liveboxandy/ZX-Spectrum-48K-Issue-6A/Issue6A.csv

Reference | Value | Footprint | Qty | Description
C1,C2,C3,C4,C5,C6,C7,C8,C26,C29,C30,C40,C41,C42,C48,C55,C56,C57,C58,C59,C60,C61,C62,C66,C76,C101,C102,C104 | 22nF | Mod:C_Axial_L3.8mm_D2.6mm_P12.70mm_Horizontal | 28 | Capacitor Ceramic MLCC
C25,C28,C34,C50,C65,C80 | 22uF | Mod:CP_Axial_L11.0mm_D6.0mm_P20.00mm_Horizontal,Mod:CP_Axial_L11.0mm_D6.0mm_P20.32mm_Horizontal | 6 | Capacitor Aluminium Electrolytic
C27,C46,C79 | 1uF | Mod:CP_Axial_L11.0mm_D6.0mm_P20.32mm_Horizontal | 3 | Capacitor Aluminium Electrolytic
C31,C32,C43,C68,C69,C70,C71,C75 | 100nF | Mod:C_Axial_L3.8mm_D2.6mm_P12.40mm_Horizontal,Mod:C_Axial_L3.8mm_D2.6mm_P12.70mm_Horizontal | 8 | Capacitor Ceramic MLCC
C33 | 47nF | Mod:C_Axial_L3.8mm_D2.6mm_P12.70mm_Horizontal | 1 | Capacitor Ceramic MLCC
C35,C39,C100 | 10nF | Mod:C_Axial_L3.8mm_D2.6mm_P12.40mm_Horizontal,Mod:C_Axial_L3.8mm_D2.6mm_P12.70mm_Horizontal,Mod:R_Yageo_L3.6mm_D1.6mm_P12.70mm_Horizontal | 3 | Capacitor Ceramic MLCC
C37,C38 | 33pF | Mod:C_Axial_L3.8mm_D2.6mm_P12.70mm_Horizontal | 2 | Capacitor Ceramic MLCC
C44,C45 | 100uF | Mod:CP_Axial_L11.0mm_D6.0mm_P20.32mm_Horizontal | 2 | Capacitor Aluminium Electrolytic
C49 | 560pF | Mod:C_Axial_L3.8mm_D2.6mm_P12.70mm_Horizontal | 1 | Capacitor Ceramic MLCC
C52,C53 | 150pF | Mod:C_Axial_L3.8mm_D2.6mm_P12.70mm_Horizontal | 2 | Capacitor Ceramic MLCC
C67 | 100pF | Mod:C_Axial_L3.8mm_D2.6mm_P12.70mm_Horizontal | 1 | Capacitor Ceramic MLCC
C72,C73 | 16pF | Mod:C_Axial_L3.8mm_D2.6mm_P12.70mm_Horizontal | 2 | Capacitor Ceramic MLCC
C74 | 4.7uF | Mod:CP_Axial_L11.0mm_D6.0mm_P20.32mm_Horizontal | 1 | Capacitor Aluminium Electrolytic
C103 | 22pF | Mod:C_Axial_L3.8mm_D2.6mm_P12.70mm_Horizontal | 1 | Capacitor Ceramic MLCC
C105 | 180pF | Mod:C_Axial_L3.8mm_D2.6mm_P12.70mm_Horizontal | 1 | Capacitor Ceramic MLCC
D1,D2,D3,D4,D5,D6,D7,D8,D9,D11,D13,D18 | 1N4148 | Mod:D_DO-35_SOD27_P12.40mm_Horizontal,Mod:D_DO-35_SOD27_P12.70mm_Horizontal | 12
D15,D17 | BA157 | Mod:D_DO-41_SOD81_P12.70mm_Horizontal | 2
D19 | 5V1 | Mod:D_DO-35_SOD27_P12.70mm_Horizontal | 1
E1 | Edge_Connector | Mod:Edge Connector | 1
EAR1 | EAR1 | Mod:3.5mm_socket | 1
IC1 | ULA | Mod:DIP-40_W15.24mm_Socket | 1
IC2 | Z80 | Mod:DIP-40_W15.24mm_Socket | 1
IC5 | ROM | Mod:DIP-28_W15.24mm_Socket | 1
IC6,IC7,IC8,IC9,IC10,IC11,IC12,IC13 | 4116 | Mod:DIP-16_W7.62mm_Socket | 8
IC14 | LM1889 | Mod:DIP-18_W7.62mm_Socket | 1
IC15,IC16,IC17,IC18,IC19,IC20,IC21,IC22 | TMS4532 | Mod:DIP-16_W7.62mm_Socket | 8
IC27 | ZX8401 | Mod:DIP-40_W15.24mm_Socket | 1
IC28 | LS04 | Mod:DIP-14_W7.62mm_Socket | 1 | Hex Inverter
J1 | Conn_02x03_Odd_Even | Mod:RASCASLINK | 1 | Generic connector, double row, 02x03, odd/even pin numbering scheme (row 1 odd numbers, row 2 even numbers), script generated (kicad-library-utils/schlib/autogen/connector/)
J2 | LKV | Mod:Link2.54 | 1 | Generic connector, single row, 01x02, script generated (kicad-library-utils/schlib/autogen/connector/)
J3 | LKU | Mod:Link2.54 | 1 | Generic connector, single row, 01x02, script generated (kicad-library-utils/schlib/autogen/connector/)
J7 | Barrel_Jack_MountingPin | Mod:BarrelJack_Horizontal | 1
JROM1 | JROM | Mod:ROM_WireLink | 1
KB1 | Keyboard5 | Mod:Keyboard5 | 1
KB2 | Keyboard8 | Mod:Keyboard8 | 1
L1 | L1 | Mod:Wire_Link_7.62mm | 1
L2 | L2 | Mod:Wire_Link_7.62mm | 1
LK1 | CLK | Mod:KEYSTONE_1430-5 | 1
LK2 | LK2 | Mod:Wire_Link_7.62mm | 1
LK3 | LK3 | Mod:Wire_Link_7.62mm | 1
LK4 | VCC/VAN | Mod:Wire_Link_7.62mm | 1
LS1 | Speaker | Mod:Speaker | 1 | Speaker
MIC1 | MIC1 | Mod:3.5mm_socket | 1
OKI-H1 | OKI-H | Mod:Wire_Link_7.62mm | 1
OKI-L1 | OKI-L | Mod:Wire_Link_7.62mm | 1
OKI1 | OKI | Mod:Wire_Link_7.62mm | 1
R1,R2,R3,R4,R5,R6,R7,R8,R17,R18,R19,R20,R21,R22,R23,R26,R27,R78 | 470R | Mod:R_Yageo_L3.6mm_D1.6mm_P12.70mm_Horizontal | 18
R9,R10,R11,R12,R13,R14,R15,R16,R89 | 8K2 | Mod:R_Yageo_L3.6mm_D1.6mm_P12.70mm_Horizontal | 9
R24,R37,R42,R45,R46,R47,R56,R58,R63,R73,R76,R77,R80,R81,R82,R83,R84,R85,R86,R88 | 1K | Mod:R_Yageo_L3.6mm_D1.6mm_P12.40mm_Horizontal,Mod:R_Yageo_L3.6mm_D1.6mm_P12.70mm_Horizontal | 20
R25 | 180R | Mod:R_Yageo_L3.6mm_D1.6mm_P12.70mm_Horizontal | 1
R28,R29,R30,R35,R49,R65,R66,R67,R68,R69,R72,R74,R75 | 10K | Mod:R_Yageo_L3.6mm_D1.6mm_P12.40mm_Horizontal,Mod:R_Yageo_L3.6mm_D1.6mm_P12.70mm_Horizontal | 13
R31 | 220K | Mod:R_Yageo_L3.6mm_D1.6mm_P12.70mm_Horizontal | 1
R33,R36 | 680R | Mod:R_Yageo_L3.6mm_D1.6mm_P12.40mm_Horizontal,Mod:R_Yageo_L3.6mm_D1.6mm_P12.70mm_Horizontal | 2
R34 | 15R 0.5W | Mod:R_Axial_DIN0516_L15.5mm_D5.0mm_P20.32mm_Horizontal | 1
R43 | 3K | Mod:R_Yageo_L3.6mm_D1.6mm_P12.70mm_Horizontal | 1
R44 | 5K1 | Mod:R_Yageo_L3.6mm_D1.6mm_P12.70mm_Horizontal | 1
R48,R51,R52,R79 | 2K2 | Mod:R_Yageo_L3.6mm_D1.6mm_P12.70mm_Horizontal | 4
R50 | 4K7 | Mod:R_Yageo_L3.6mm_D1.6mm_P12.70mm_Horizontal | 1
R53 | 390R | Mod:R_Yageo_L3.6mm_D1.6mm_P12.70mm_Horizontal | 1
R59 | 1K8 | Mod:R_Yageo_L3.6mm_D1.6mm_P12.70mm_Horizontal | 1
R60 | 220R | Mod:R_Yageo_L3.6mm_D1.6mm_P12.70mm_Horizontal | 1
R61,R62,R64 | 15R | Mod:R_Yageo_L3.6mm_D1.6mm_P12.70mm_Horizontal | 3
R87 | 0R | Mod:R_Yageo_L3.6mm_D1.6mm_P12.70mm_Horizontal | 1
R90 | 2K7 | Mod:R_Yageo_L3.6mm_D1.6mm_P12.70mm_Horizontal | 1
REG1 | 7805 | Mod:TO-220-3_Horizontal_TabDown | 1
SW1 | SW_SPDT | Mod:SHM1260H | 1 | Switch, single pole double throw
SW2 | Optional RESET Switch | Mod:PinHeader_1x02_P2.54mm_Vertical | 1 | Push button switch, generic, two pins
T1 | Transformer_1P_1S | Mod:Coil | 1
TI-3 | TI-3 | Mod:Wire_Link_7.62mm | 1
TI-4 | TI-4 | Mod:Wire_Link_7.62mm | 1
TI1 | TI | Mod:Wire_Link_7.62mm | 1
TR1,TR2,TR3,TR6 | ZTX313 | Mod:TO-92Flat | 4
TR4 | ZTX650 | Mod:TO-92Flat | 1
TR5 | ZTX213 | Mod:TO-92Flat | 1
TR7 | ZTX450 | Mod:TO-92Flat | 1
TR8,TR9 | BC184 | Mod:TR9 | 2
TV1 | TV | Mod:Modulator4B | 1
X1 | 14Mhz | Mod:X1 | 1
X2 | 4.43Mhz | Mod:X2 | 1
