liveboxandy/ZX-Spectrum-48K-Issue-6A/STPS/SS12SDH4.stp

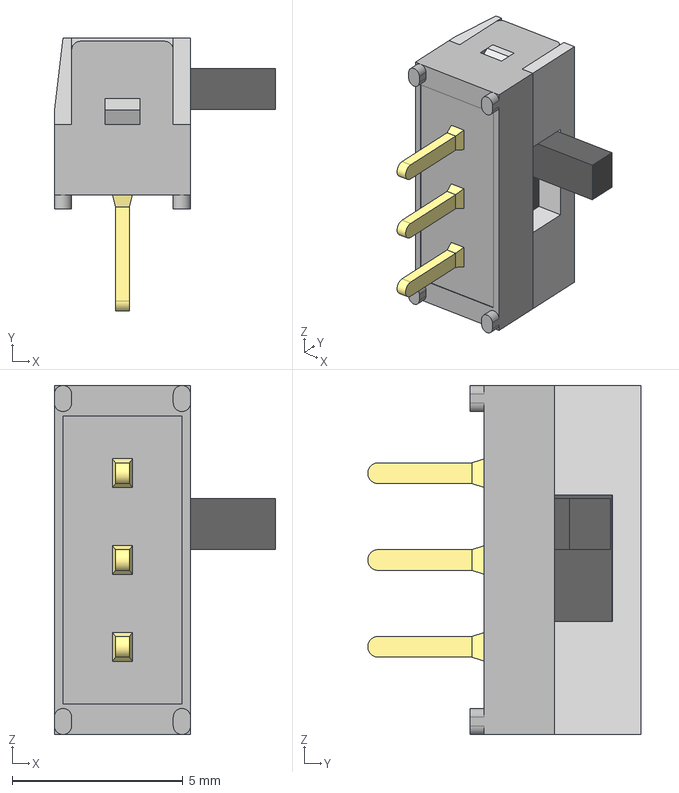
[picture p3: CAD file, 2026-10-21]
STPS/SS12SDH4.stp
6.48 x 8.00 x 10.2 mm
SS12SDH4body2
SS12SDH4trmd
SS12SDH4side
SS12SDH4actus
