liveboxandy/ZX-Spectrum-48K-Issue-6A/STPS/PCF1306.step

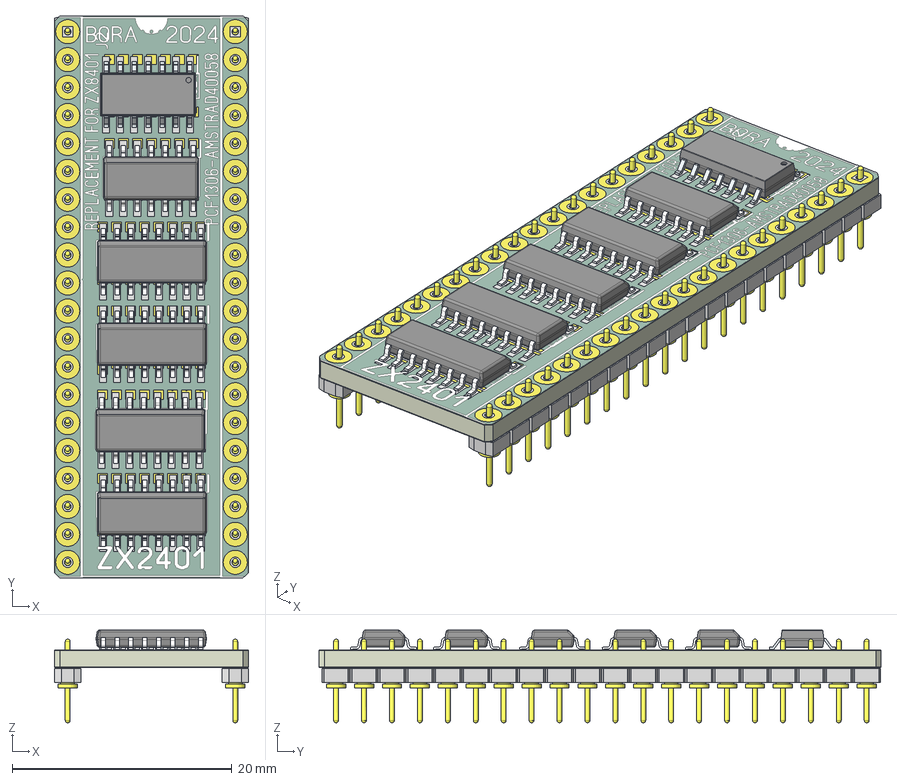
[picture p4: CAD file, 2026-10-21]
STPS/PCF1306.step
17.7 x 51.1 x 8.43 mm
PinsArrayLR
BODY-SO x 5
LEAD-SO x 78
PIN1-ID x 5
BBL-120-G-E_pins x 40
BBL-120-G-E_socket x 2
PCF4D62_copper
PCF4D62_pad
PCF4D62_via
PCF4D62_silkscreen x 2
PCF4D62_soldermask x 2
PCF4D62_PCB
