liveboxandy/ZX-Spectrum-48K-Issue-6A/Issue6A.pdf

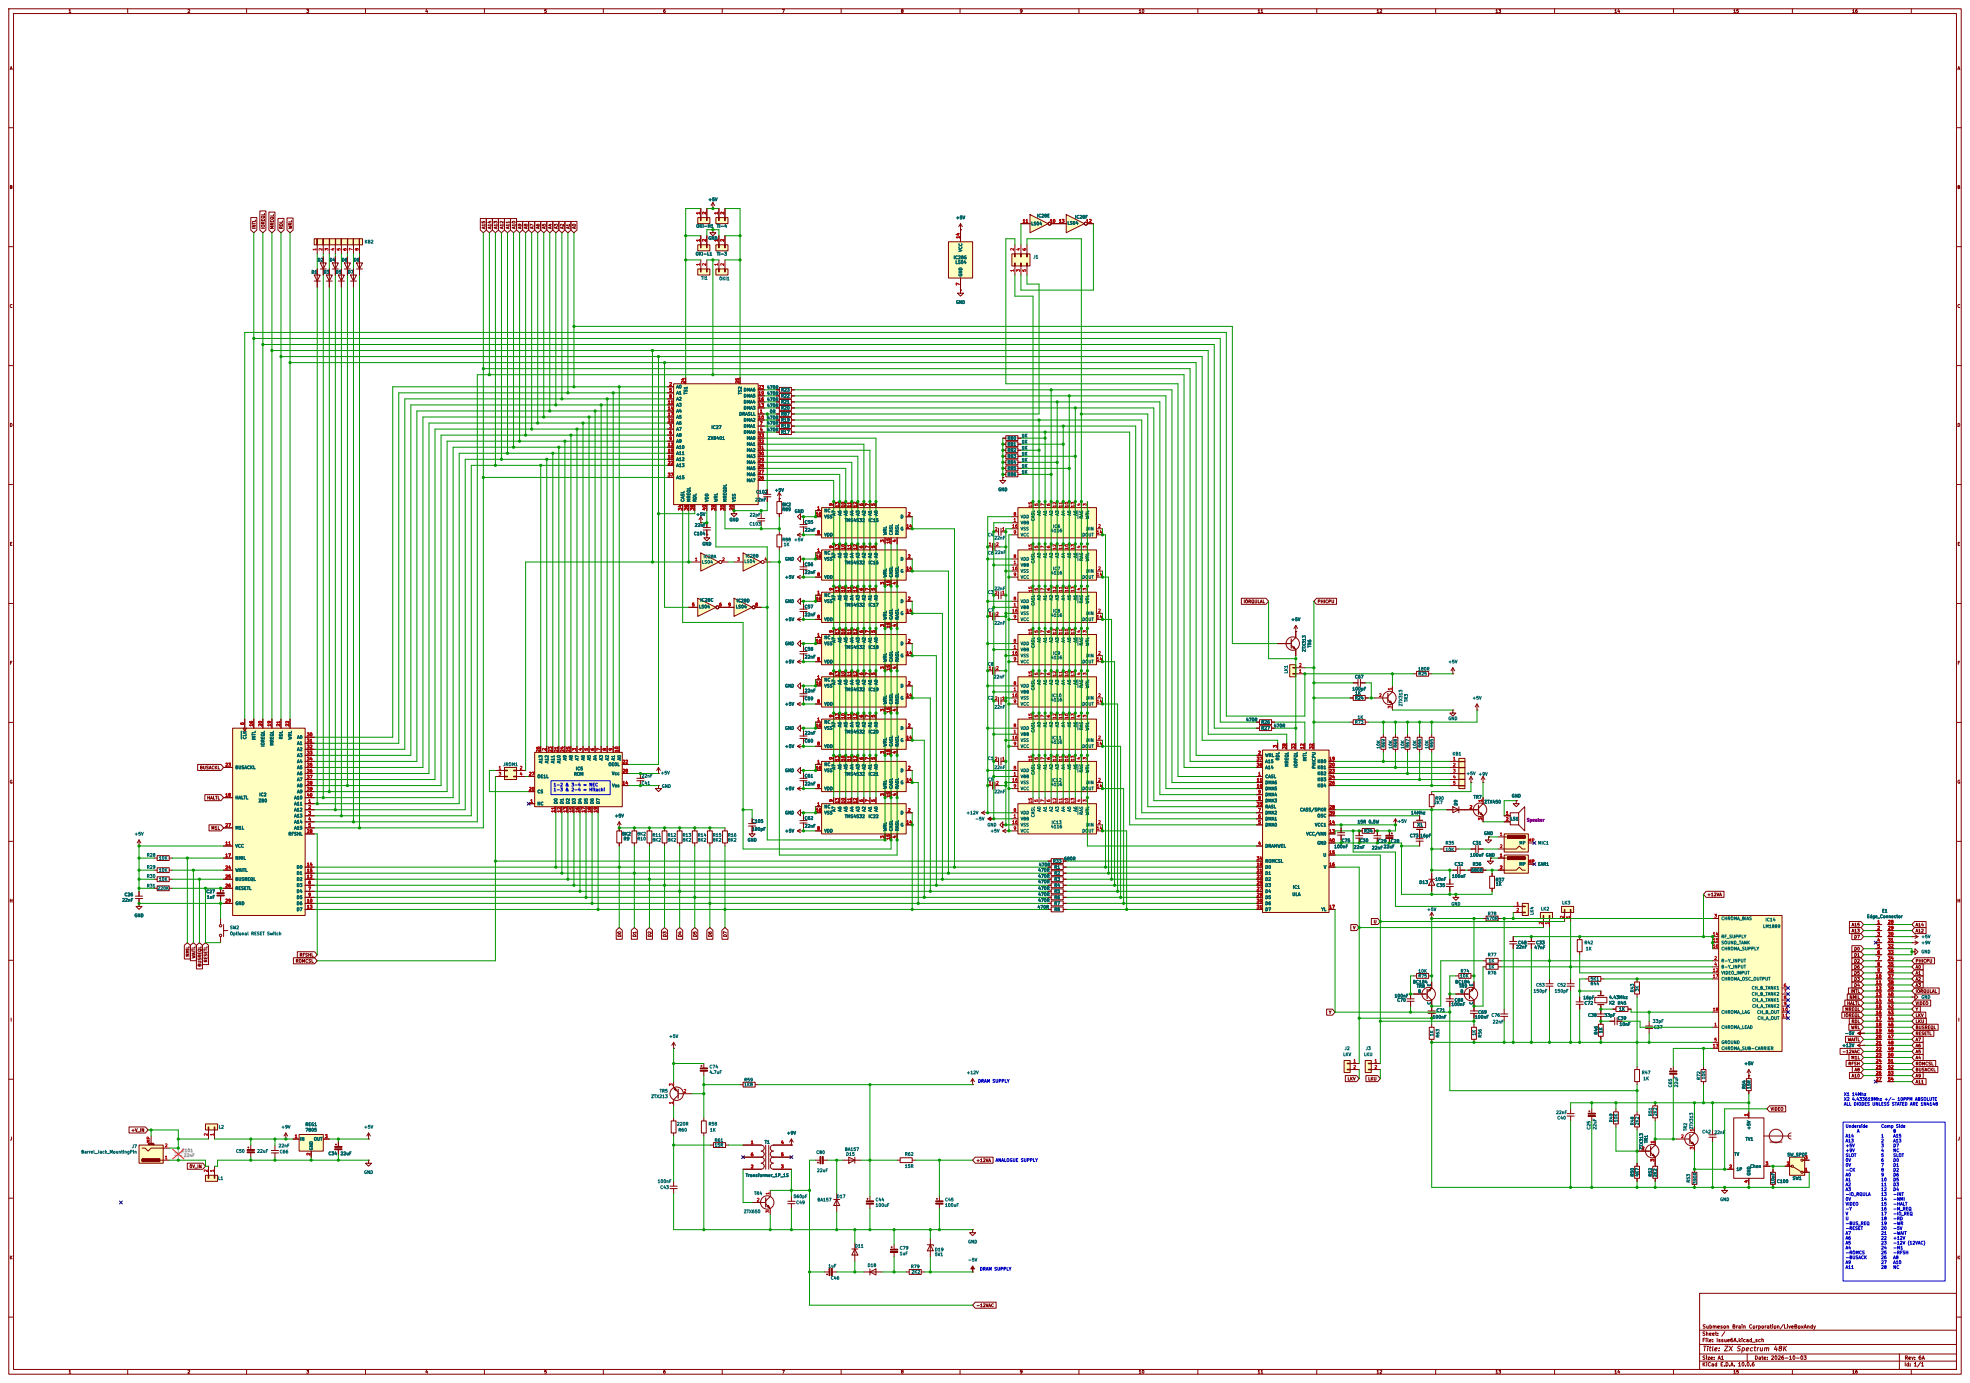
[picture p5: page 1]

ANALOGUE SUPPLY DRAM SUPPLY DRAM SUPPLY

ALL DIODES UNLESS STATED ARE 1N4148

Submeson Brain Corporation/LiveBoxAndy
Sheet: /
File: Issue6A.kicad_sch
Title: ZX Spectrum 48K

Size: A1 | Rev: 6A
KiCad E.D.A. 10.0.6 | Id: 1/1
