liveboxandy/ZX-Spectrum-48K-Issue-6A/Issue6A.kicad_pcb

## KiCad design Issue6A.kicad_pcb (2026-10-21)

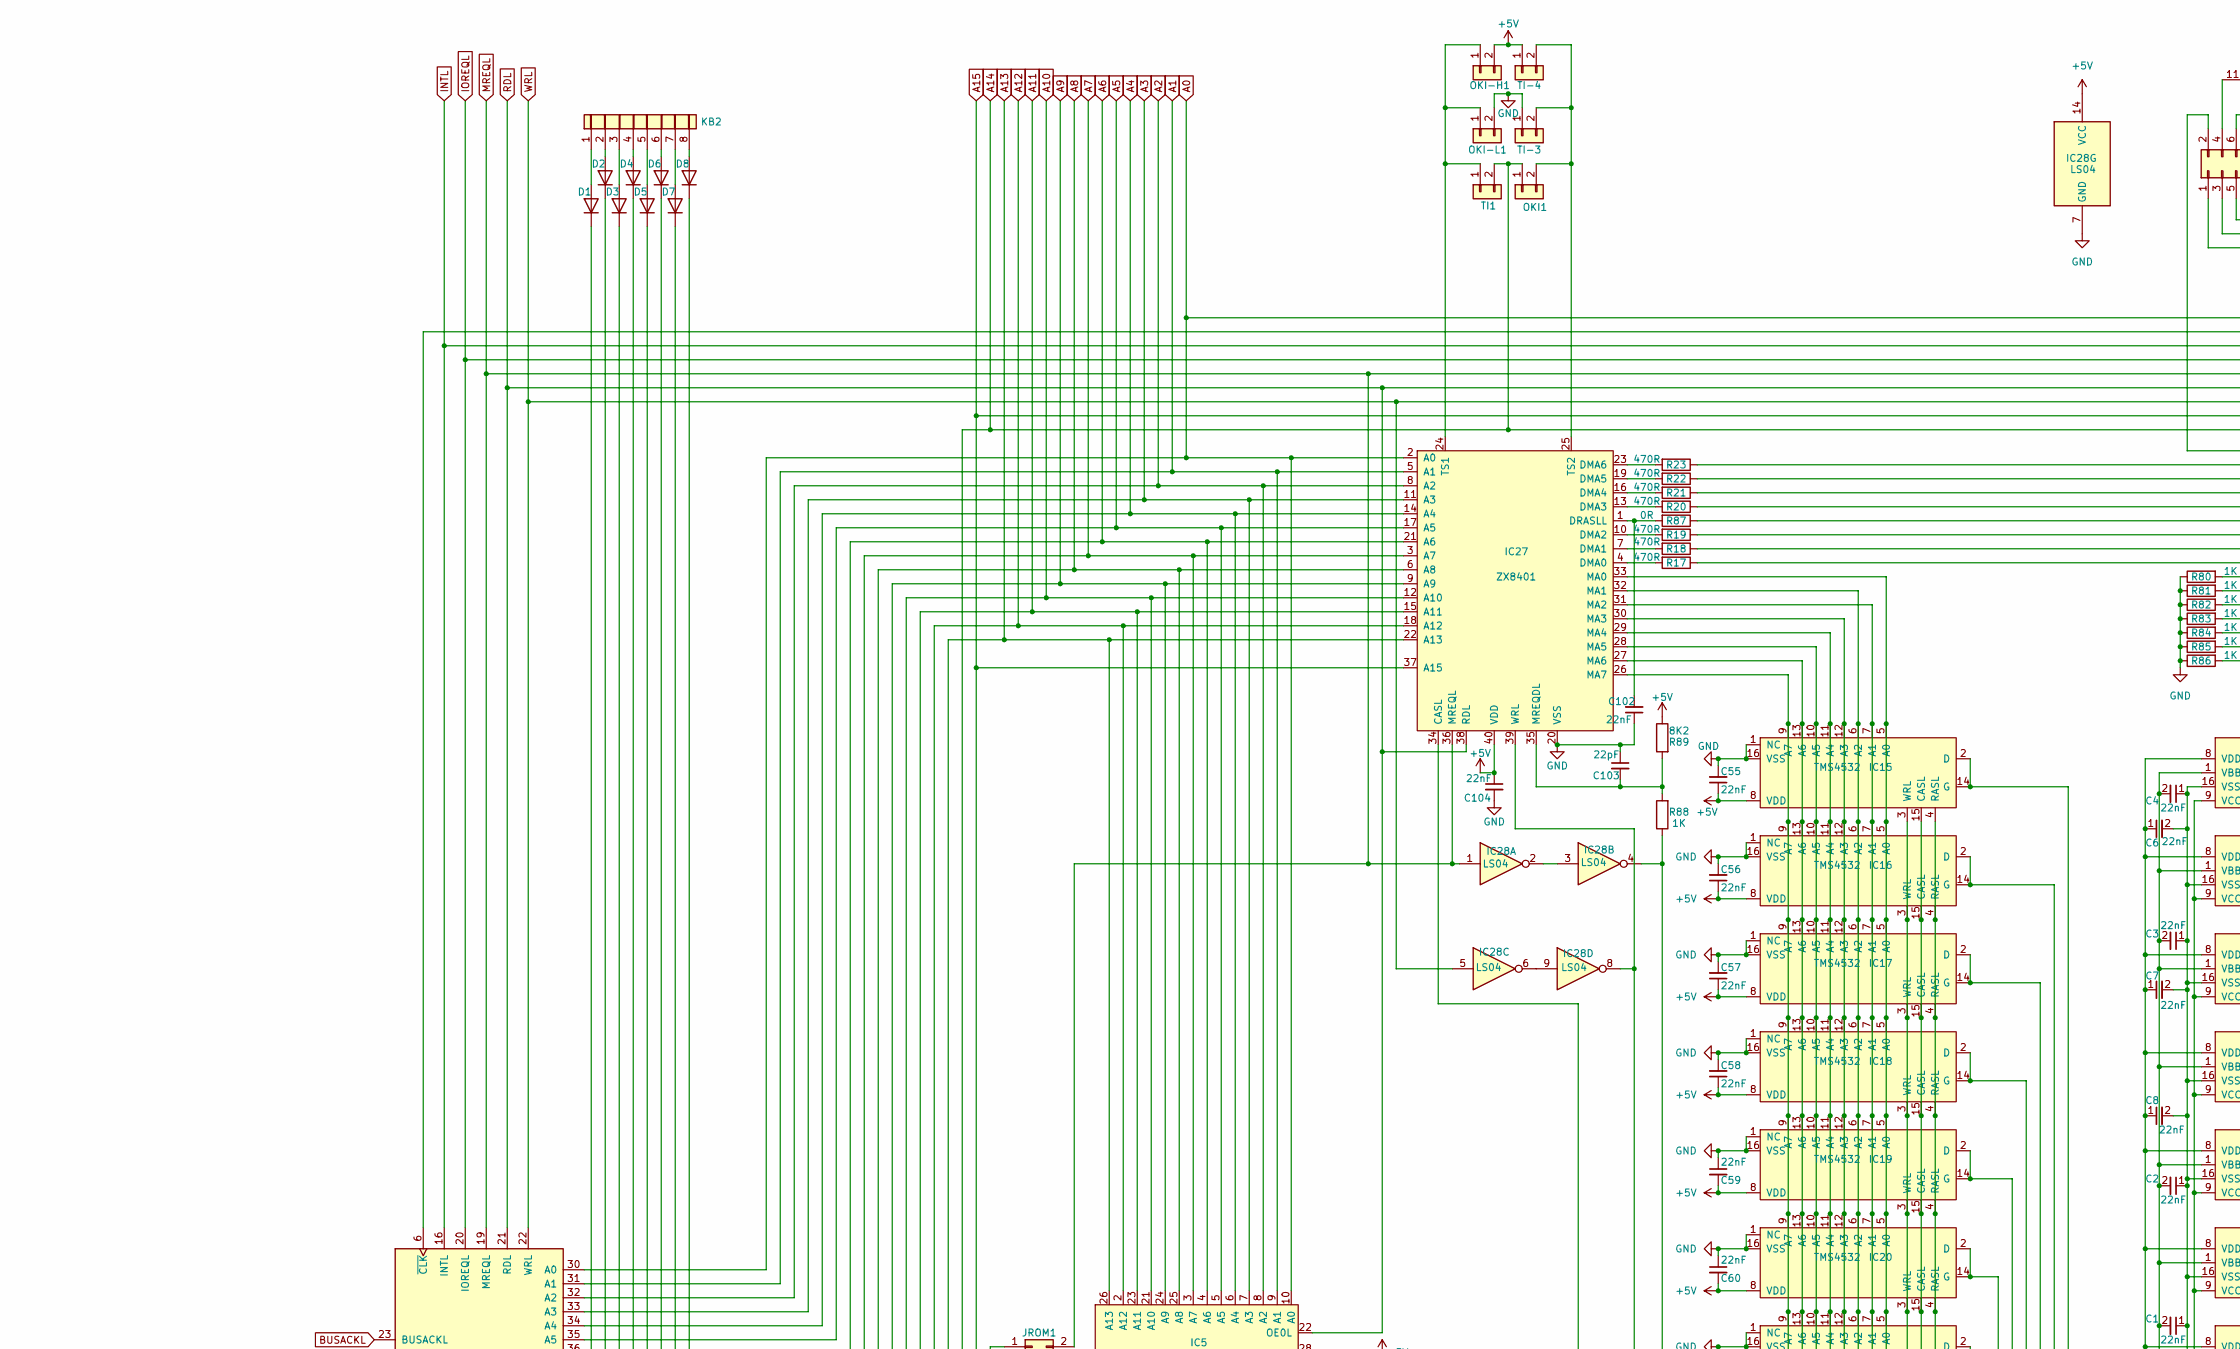
[picture p6: schematic Issue6A.kicad_sch, ZX Spectrum 48K, part in row 1, column 1]

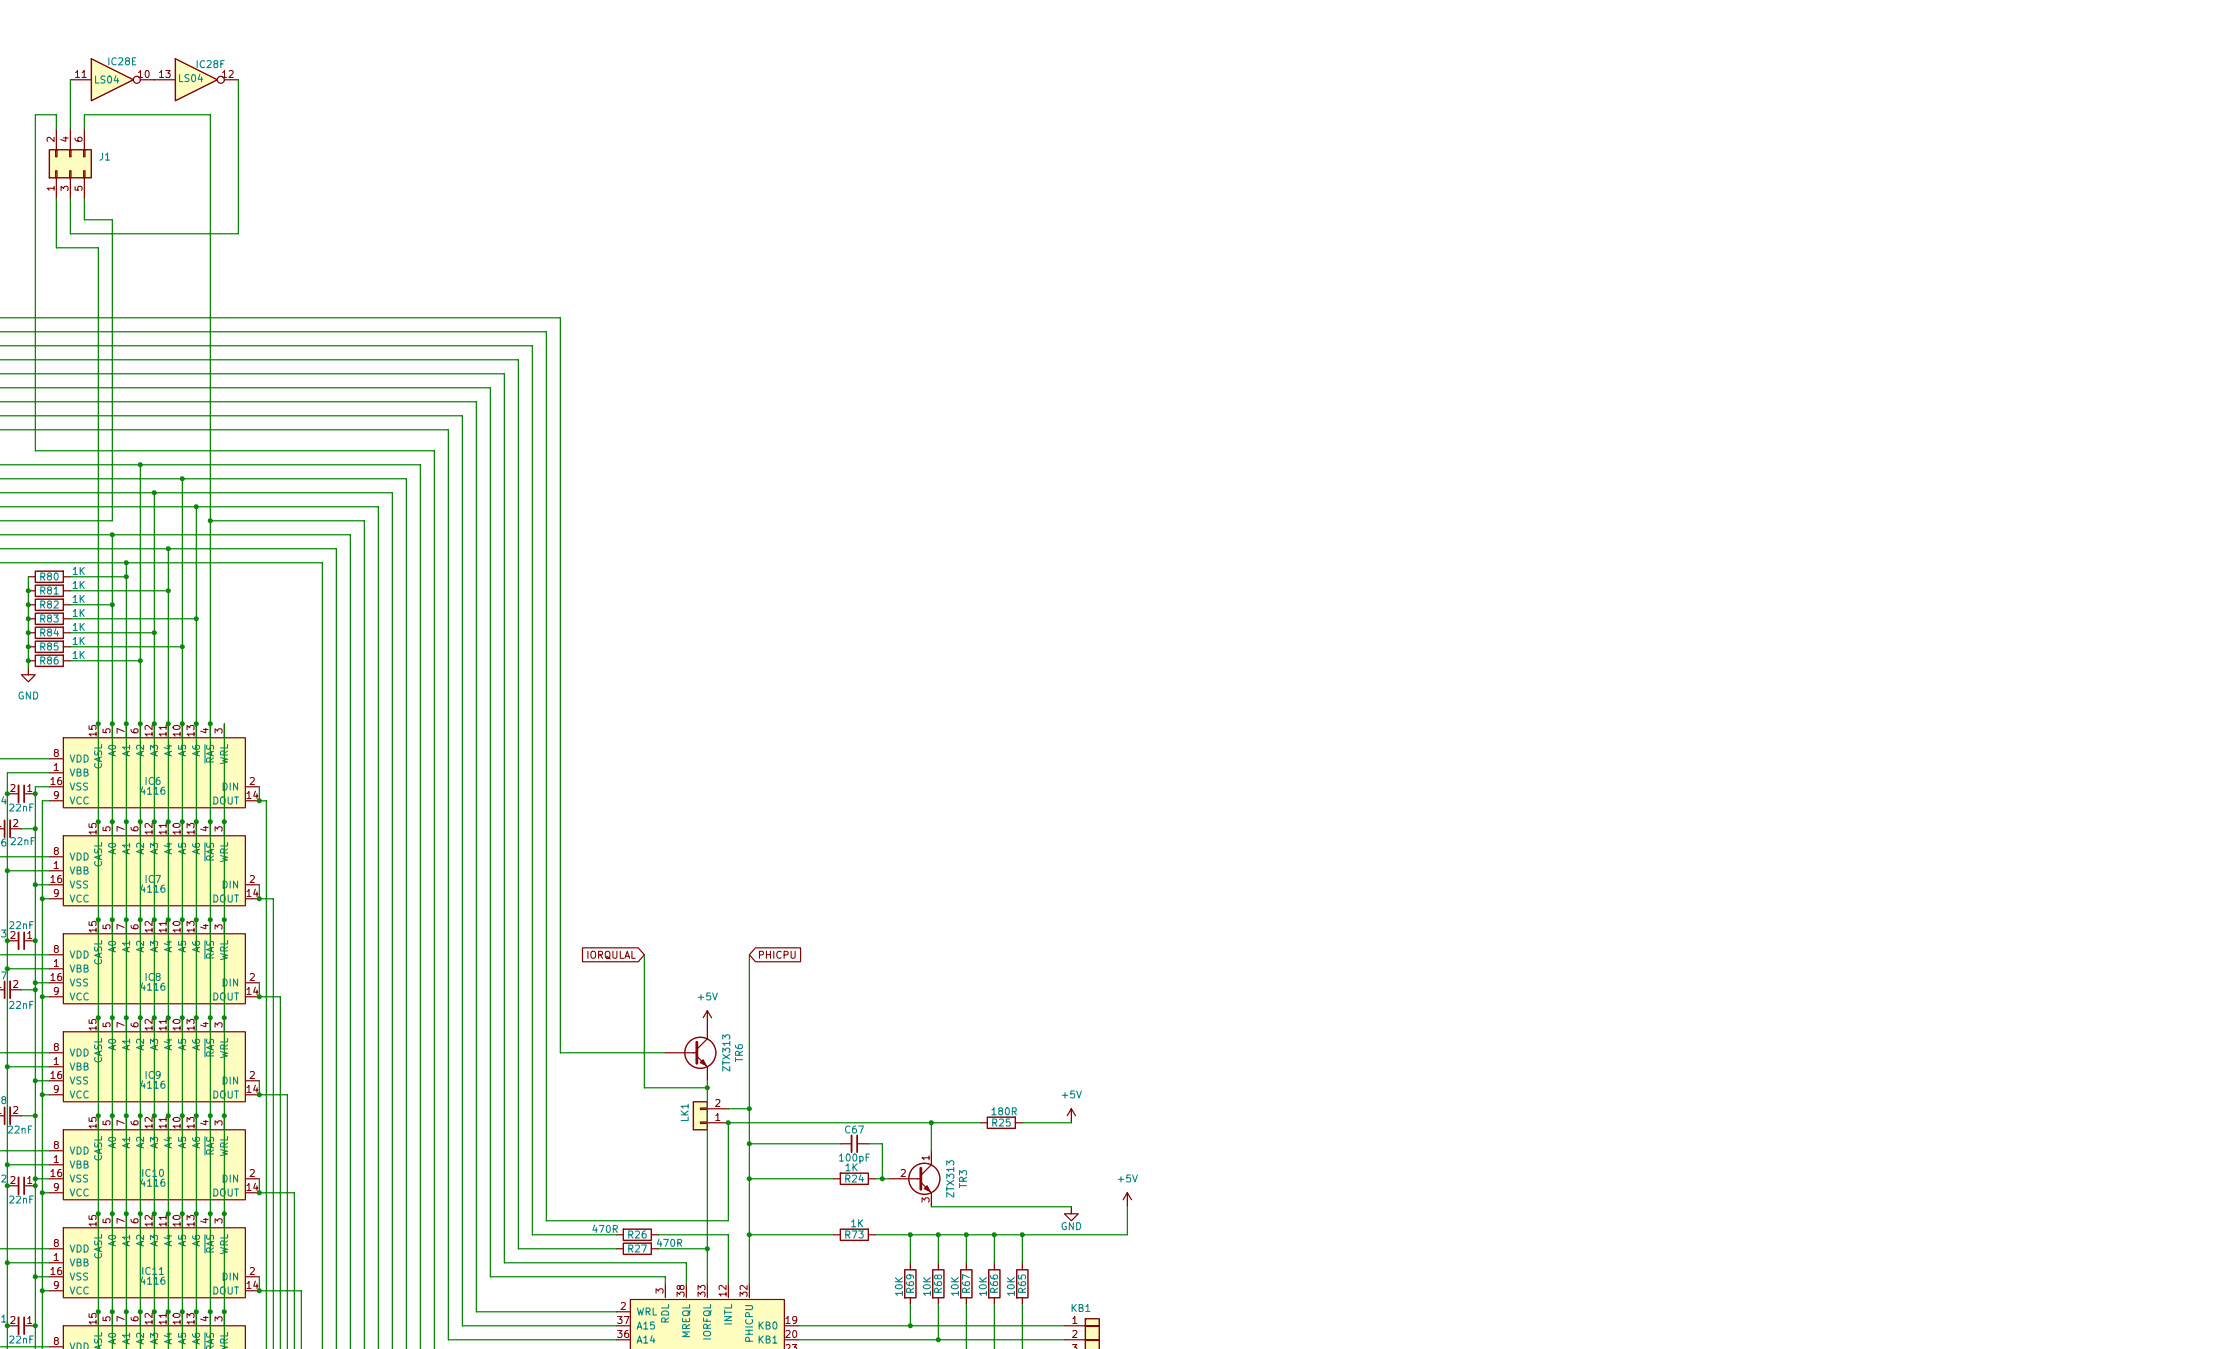
[picture p7: schematic Issue6A.kicad_sch, ZX Spectrum 48K, part in row 1, column 2]

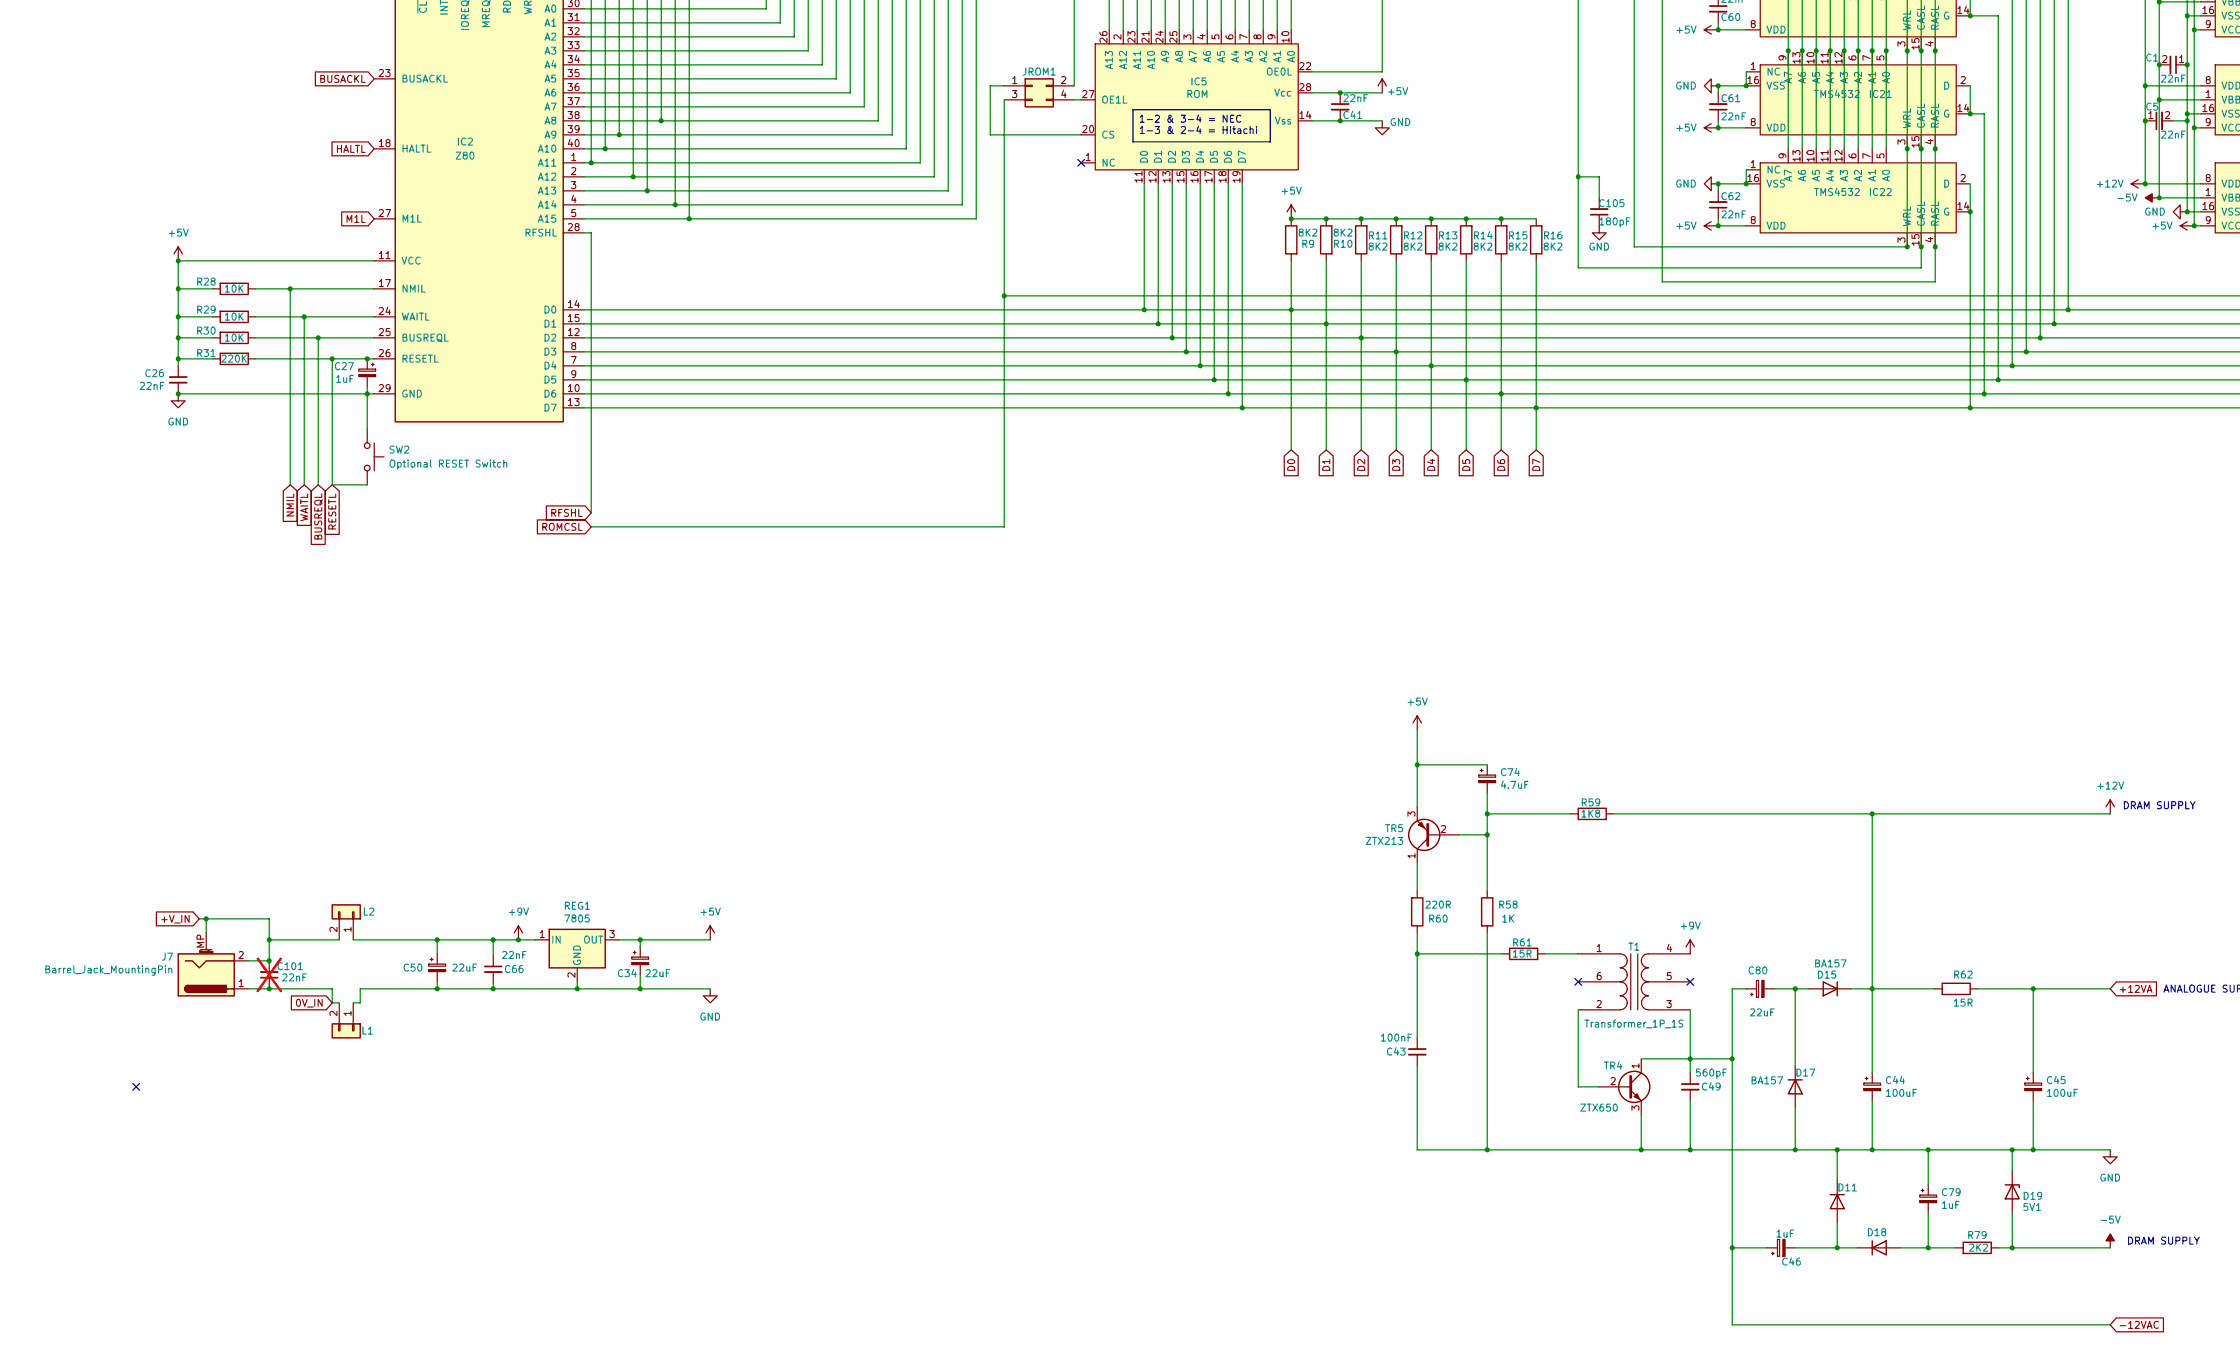
[picture p8: schematic Issue6A.kicad_sch, ZX Spectrum 48K, part in row 2, column 1]

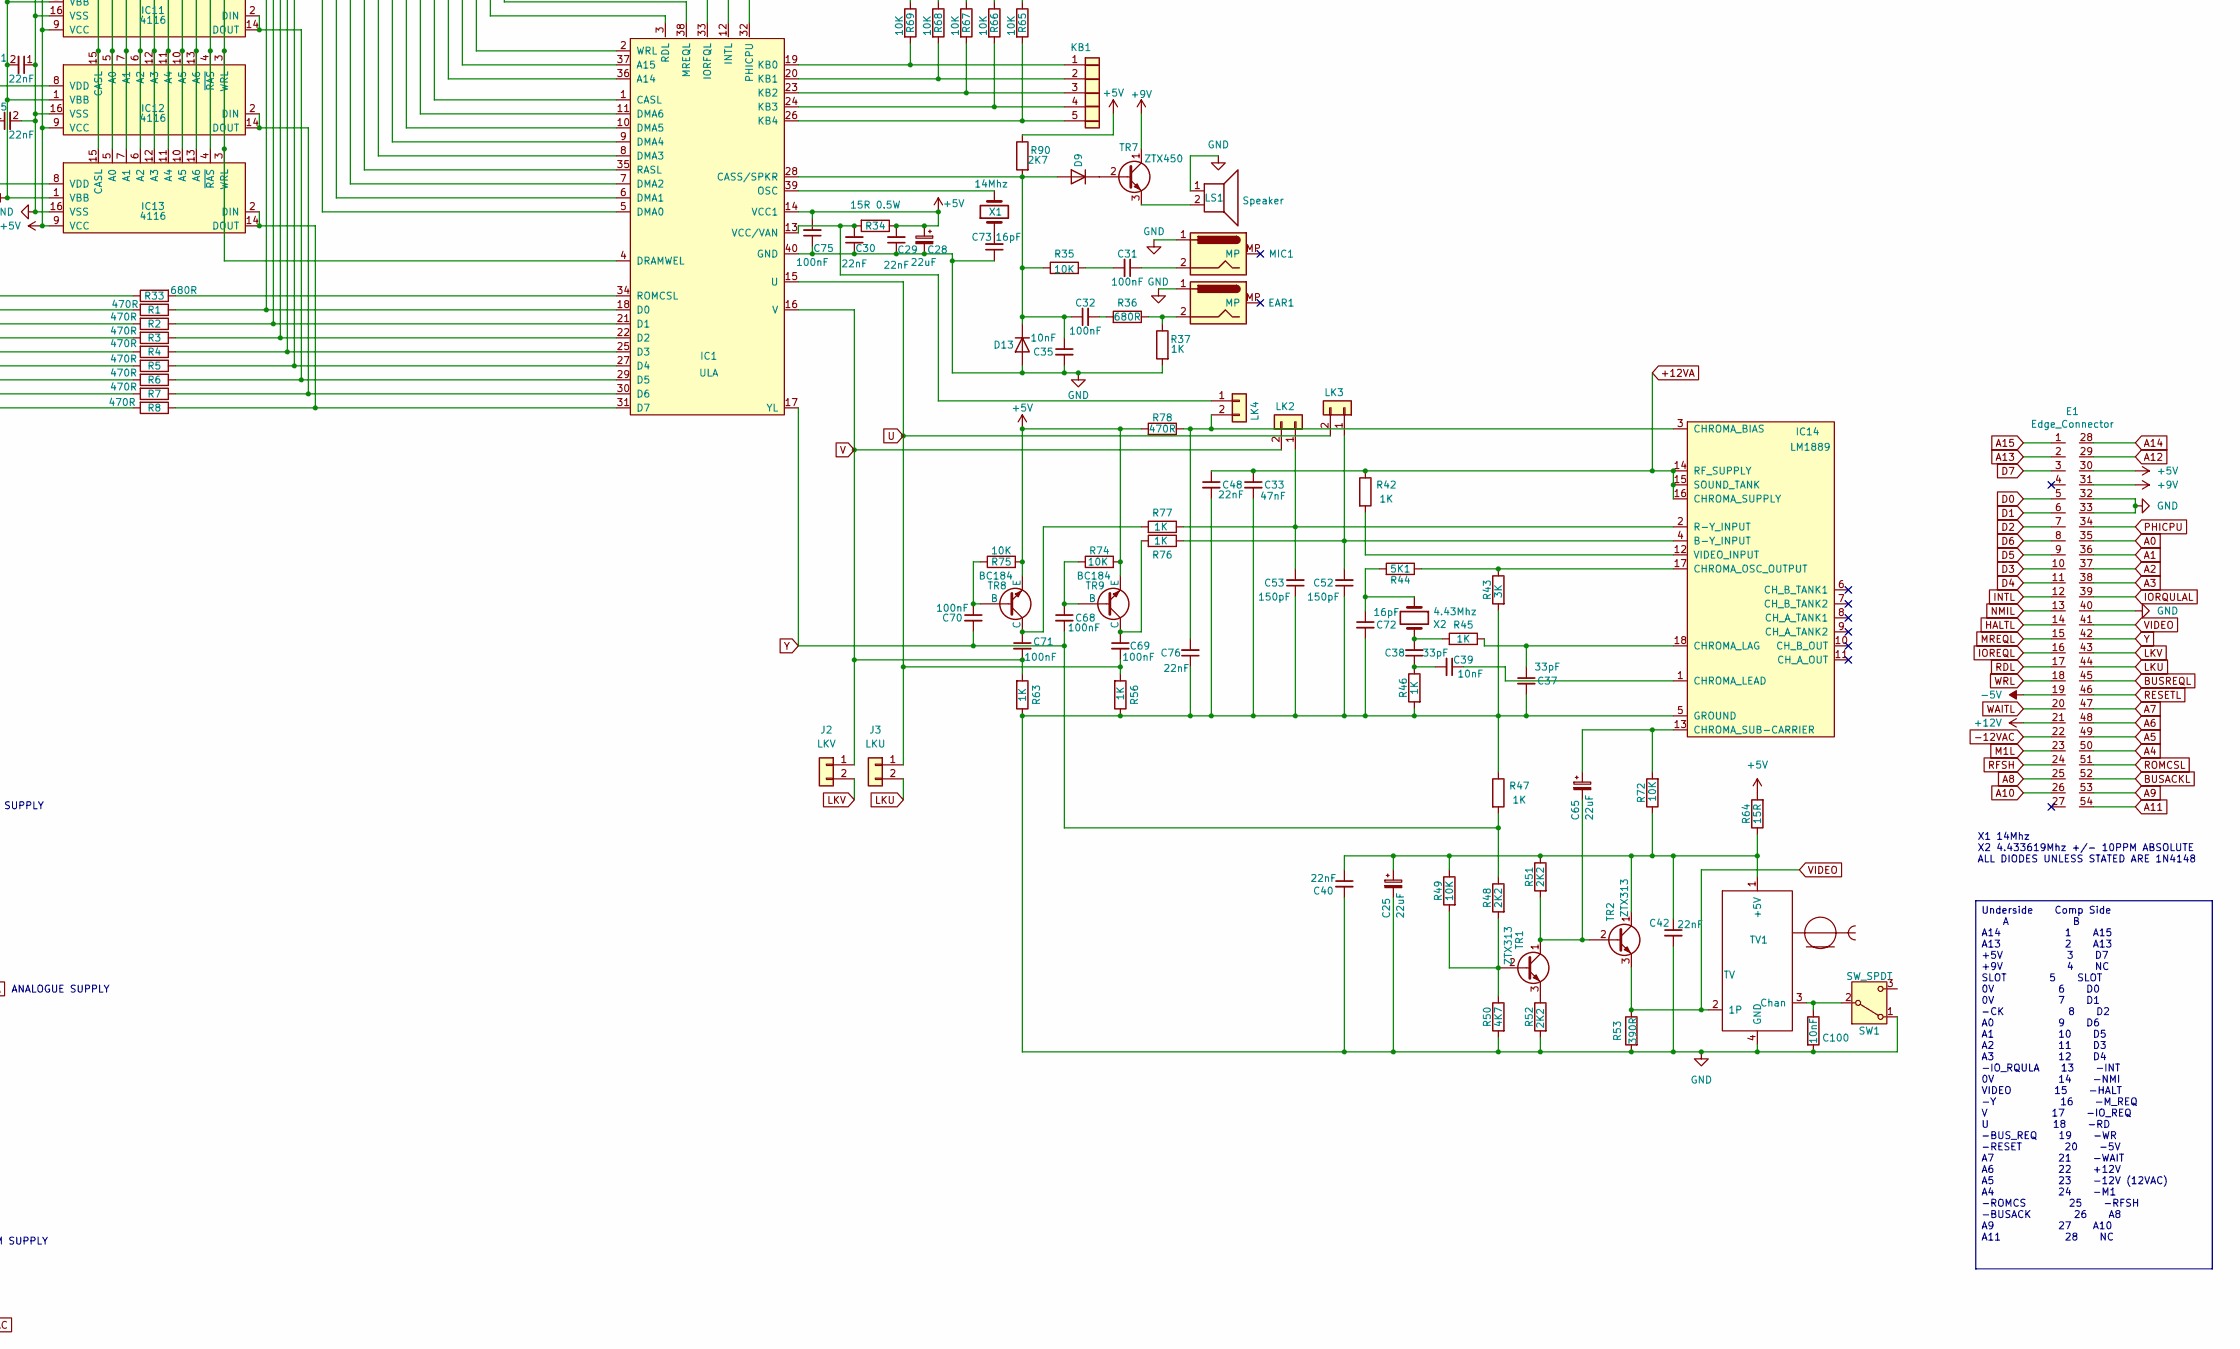
[picture p9: schematic Issue6A.kicad_sch, ZX Spectrum 48K, part in row 2, column 2]

Parts:
C1, C2, C3, C4, C5, C6, C7, C8, C26, C29, C30, C40, C41, C42, C48, C55, C56, C57, C58, C59, C60, C61, C62, C66, C76, C102, C104: 22nF; C_Axial_L3.8mm_D2.6mm_P12.70mm_Horizontal
C25: 22uF; CP_Axial_L11.0mm_D6.0mm_P20.00mm_Horizontal
C27, C46, C79: 1uF; CP_Axial_L11.0mm_D6.0mm_P20.32mm_Horizontal
C28, C34, C50, C65, C80: 22uF; CP_Axial_L11.0mm_D6.0mm_P20.32mm_Horizontal
C31, C32: 100nF; C_Axial_L3.8mm_D2.6mm_P12.40mm_Horizontal
C33: 47nF; C_Axial_L3.8mm_D2.6mm_P12.70mm_Horizontal
C35: 10nF; C_Axial_L3.8mm_D2.6mm_P12.40mm_Horizontal
C37, C38: 33pF; C_Axial_L3.8mm_D2.6mm_P12.70mm_Horizontal
C39: 10nF; C_Axial_L3.8mm_D2.6mm_P12.70mm_Horizontal
C43, C68, C69, C70, C71, C75: 100nF; C_Axial_L3.8mm_D2.6mm_P12.70mm_Horizontal
C44, C45: 100uF; CP_Axial_L11.0mm_D6.0mm_P20.32mm_Horizontal
C49: 560pF; C_Axial_L3.8mm_D2.6mm_P12.70mm_Horizontal
C52, C53: 150pF; C_Axial_L3.8mm_D2.6mm_P12.70mm_Horizontal
C67: 100pF; C_Axial_L3.8mm_D2.6mm_P12.70mm_Horizontal
C72, C73: 16pF; C_Axial_L3.8mm_D2.6mm_P12.70mm_Horizontal
C74: 4.7uF; CP_Axial_L11.0mm_D6.0mm_P20.32mm_Horizontal
C100: 10nF; R_Yageo_L3.6mm_D1.6mm_P12.70mm_Horizontal
C101: 22nF; C_Axial_L3.8mm_D2.6mm_P12.70mm_Horizontal; not fitted
C103: 22pF; C_Axial_L3.8mm_D2.6mm_P12.70mm_Horizontal
C105: 180pF; C_Axial_L3.8mm_D2.6mm_P12.70mm_Horizontal
D1, D2, D3, D4, D5, D6, D7, D8, D9, D11, D18: 1N4148; D_DO-35_SOD27_P12.70mm_Horizontal
D13: 1N4148; D_DO-35_SOD27_P12.40mm_Horizontal
D15, D17: BA157; D_DO-41_SOD81_P12.70mm_Horizontal
D19: 5V1; D_DO-35_SOD27_P12.70mm_Horizontal
E1: Edge_Connector; Edge Connector
EAR1: EAR1; 3.5mm_socket
IC1: ULA; DIP-40_W15.24mm_Socket
IC2: Z80; DIP-40_W15.24mm_Socket
IC5: ROM; DIP-28_W15.24mm_Socket
IC6, IC7, IC8, IC9, IC10, IC11, IC12, IC13: 4116; DIP-16_W7.62mm_Socket
IC14: LM1889; DIP-18_W7.62mm_Socket
IC15, IC16, IC17, IC18, IC19, IC20, IC21, IC22: TMS4532; DIP-16_W7.62mm_Socket
IC27: ZX8401; DIP-40_W15.24mm_Socket
IC28: LS04; DIP-14_W7.62mm_Socket
J1: Conn_02x03_Odd_Even; RASCASLINK
J2: LKV; Link2.54
J3: LKU; Link2.54
J7: Barrel_Jack_MountingPin; BarrelJack_Horizontal
JROM1: JROM; ROM_WireLink
KB1: Keyboard5
KB2: Keyboard8
L1: L1; Wire_Link_7.62mm
L2: L2; Wire_Link_7.62mm
LK1: CLK; KEYSTONE_1430-5
LK2: LK2; Wire_Link_7.62mm
LK3: LK3; Wire_Link_7.62mm
LK4: VCC/VAN; Wire_Link_7.62mm
LS1: Speaker
MIC1: MIC1; 3.5mm_socket
OKI1: OKI; Wire_Link_7.62mm
OKI-H1: OKI-H; Wire_Link_7.62mm
OKI-L1: OKI-L; Wire_Link_7.62mm
R1, R2, R3, R4, R5, R6, R7, R8, R17, R18, R19, R20, R21, R22, R23, R26, R27, R78: 470R; R_Yageo_L3.6mm_D1.6mm_P12.70mm_Horizontal
R9, R10, R11, R12, R13, R14, R15, R16, R89: 8K2; R_Yageo_L3.6mm_D1.6mm_P12.70mm_Horizontal
R24, R42, R45, R46, R47, R56, R58, R63, R73, R76, R77, R80, R81, R82, R83, R84, R85, R86, R88: 1K; R_Yageo_L3.6mm_D1.6mm_P12.70mm_Horizontal
R25: 180R; R_Yageo_L3.6mm_D1.6mm_P12.70mm_Horizontal
R28, R29, R30, R49, R65, R66, R67, R68, R69, R72, R74, R75: 10K; R_Yageo_L3.6mm_D1.6mm_P12.70mm_Horizontal
R31: 220K; R_Yageo_L3.6mm_D1.6mm_P12.70mm_Horizontal
R33: 680R; R_Yageo_L3.6mm_D1.6mm_P12.70mm_Horizontal
R34: 15R 0.5W; R_Axial_DIN0516_L15.5mm_D5.0mm_P20.32mm_Horizontal
R35: 10K; R_Yageo_L3.6mm_D1.6mm_P12.40mm_Horizontal
R36: 680R; R_Yageo_L3.6mm_D1.6mm_P12.40mm_Horizontal
R37: 1K; R_Yageo_L3.6mm_D1.6mm_P12.40mm_Horizontal
R43: 3K; R_Yageo_L3.6mm_D1.6mm_P12.70mm_Horizontal
R44: 5K1; R_Yageo_L3.6mm_D1.6mm_P12.70mm_Horizontal
R48, R51, R52, R79: 2K2; R_Yageo_L3.6mm_D1.6mm_P12.70mm_Horizontal
R50: 4K7; R_Yageo_L3.6mm_D1.6mm_P12.70mm_Horizontal
R53: 390R; R_Yageo_L3.6mm_D1.6mm_P12.70mm_Horizontal
R59: 1K8; R_Yageo_L3.6mm_D1.6mm_P12.70mm_Horizontal
R60: 220R; R_Yageo_L3.6mm_D1.6mm_P12.70mm_Horizontal
R61, R62, R64: 15R; R_Yageo_L3.6mm_D1.6mm_P12.70mm_Horizontal
R87: 0R; R_Yageo_L3.6mm_D1.6mm_P12.70mm_Horizontal
R90: 2K7; R_Yageo_L3.6mm_D1.6mm_P12.70mm_Horizontal
REG1: 7805; TO-220-3_Horizontal_TabDown
SW1: SW_SPDT; SHM1260H
SW2: Optional RESET Switch; PinHeader_1x02_P2.54mm_Vertical
T1: Transformer_1P_1S; Coil
TI1: TI; Wire_Link_7.62mm
TI-3: TI-3; Wire_Link_7.62mm
TI-4: TI-4; Wire_Link_7.62mm
TR1, TR2, TR3, TR6: ZTX313; TO-92Flat
TR4: ZTX650; TO-92Flat
TR5: ZTX213; TO-92Flat
TR7: ZTX450; TO-92Flat
TR8, TR9: BC184; TR9
TV1: TV; Modulator4B
X1: 14Mhz; X1
X2: 4.43Mhz; X2

Connections:
0V_IN: C101.1, J7.1, L1.2
+5V: C26.1, C28.1, C29.2, C34.1, C41.1, C55.1, C56.1, C57.1, C58.1, C59.2, C60.2, C61.1, C62.1, C74.1, C75.2, C104.1, E1.30, IC1.14 (VCC1), IC2.11 (VCC), IC5.28 (Vcc), IC6.9 (VCC), IC7.9 (VCC), IC8.9 (VCC), IC9.9 (VCC), IC10.9 (VCC), IC11.9 (VCC), IC12.9 (VCC), IC13.9 (VCC), IC15.8 (VDD), IC16.8 (VDD), IC17.8 (VDD), IC18.8 (VDD), IC19.8 (VDD), IC20.8 (VDD), IC21.8 (VDD), IC22.8 (VDD), IC27.40 (VDD), IC28.14 (VCC), OKI-H1.2, R9.1, R10.1, R11.2, R12.2, R13.2, R14.2, R15.2, R16.2, R25.2, R28.2, R29.2, R30.2, R31.1, R34.1, R64.2, R65.1, R66.1, R67.1, R68.1, R69.1, R73.2, R74.2, R75.2, R78.2, R89.1, R90.1, REG1.3 (OUT), TI-4.1, TR5.3 (E), TR6.1 (C), TR8.3 (E), TR9.3 (E)
+9V: C50.1, C66.1, E1.31, L2.1, REG1.1 (IN), T1.4 (SB), TR7.1 (C)
+12V: C5.1, C6.1, C7.1, C8.1, C44.1, D15.1 (K), E1.21, IC6.8 (VDD), IC7.8 (VDD), IC8.8 (VDD), IC9.8 (VDD), IC10.8 (VDD), IC11.8 (VDD), IC12.8 (VDD), IC13.8 (VDD), R59.2, R62.2
+12VA: C33.1, C45.1, C48.1, IC14.14 (RF_SUPPLY), IC14.15 (SOUND_TANK), IC14.16 (CHROMA_SUPPLY), R42.1, R62.1
+V_IN: C101.2, J7.2, J7.MP (MountPin_MP), L2.2
-5V: C1.2, C2.2, C3.2, C4.2, D19.2 (A), E1.19, IC6.1 (VBB), IC7.1 (VBB), IC8.1 (VBB), IC9.1 (VBB), IC10.1 (VBB), IC11.1 (VBB), IC12.1 (VBB), IC13.1 (VBB), R79.1
-12VAC: C46.1, C49.1, C80.1, E1.22, T1.3 (SA), TR4.1 (C)
A0: E1.35, IC2.30 (A0), IC5.10 (A0), IC27.2 (A0), TR6.2 (B)
A1: E1.36, IC2.31 (A1), IC5.9 (A1), IC27.5 (A1)
A2: E1.37, IC2.32 (A2), IC5.8 (A2), IC27.8 (A2)
A3: E1.38, IC2.33 (A3), IC5.7 (A3), IC27.11 (A3)
A4: E1.50, IC2.34 (A4), IC5.6 (A4), IC27.14 (A4)
A5: E1.49, IC2.35 (A5), IC5.5 (A5), IC27.17 (A5)
A6: E1.48, IC2.36 (A6), IC5.4 (A6), IC27.21 (A6)
A7: E1.47, IC2.37 (A7), IC5.3 (A7), IC27.3 (A7)
A8: D6.1 (K), E1.25, IC2.38 (A8), IC5.25 (A8), IC27.6 (A8)
A9: D3.1 (K), E1.53, IC2.39 (A9), IC5.24 (A9), IC27.9 (A9)
A10: D2.1 (K), E1.26, IC2.40 (A10), IC5.21 (A10), IC27.12 (A10)
A11: D1.1 (K), E1.54, IC2.1 (A11), IC5.23 (A11), IC27.15 (A11)
A12: D4.1 (K), E1.29, IC2.2 (A12), IC5.2 (A12), IC27.18 (A12)
A13: D5.1 (K), E1.2, IC2.3 (A13), IC5.26 (A13), IC27.22 (A13)
A14: D7.1 (K), E1.28, IC1.36 (A14), IC2.4 (A14), OKI1.1, TI1.2
A15: D8.1 (K), E1.1, IC1.37 (A15), IC2.5 (A15), IC27.37 (A15)
BUSACKL: E1.52, IC2.23 (BUSACKL)
BUSREQL: E1.45, IC2.25 (BUSREQL), R30.1
D0: E1.5, IC2.14 (D0), IC5.11 (D0), IC15.2 (D), IC15.14 (G), R1.2, R9.2
D1: E1.6, IC2.15 (D1), IC5.12 (D1), IC16.2 (D), IC16.14 (G), R2.2, R10.2
D2: E1.7, IC2.12 (D2), IC5.13 (D2), IC17.2 (D), IC17.14 (G), R3.2, R11.1
D3: E1.10, IC2.8 (D3), IC5.15 (D3), IC18.2 (D), IC18.14 (G), R4.2, R12.1
D4: E1.11, IC2.7 (D4), IC5.16 (D4), IC19.2 (D), IC19.14 (G), R5.2, R13.1
D5: E1.9, IC2.9 (D5), IC5.17 (D5), IC20.2 (D), IC20.14 (G), R6.2, R14.1
D6: E1.8, IC2.10 (D6), IC5.18 (D6), IC21.2 (D), IC21.14 (G), R7.2, R15.1
D7: E1.3, IC2.13 (D7), IC5.19 (D7), IC22.2 (D), IC22.14 (G), R8.2, R16.1
GND: C1.1, C2.1, C3.1, C4.1, C5.2, C6.2, C7.2, C8.2, C25.2, C26.2, C27.2, C28.2, C29.1, C30.1, C33.2, C34.2, C35.2, C37.2, C40.2, C41.2, C42.2, C43.2, C44.2, C45.2, C48.2, C49.2, C50.2, C52.1, C53.1, C55.2, C56.2, C57.2, C58.2, C59.1, C60.1, C61.2, C62.2, C66.2, C72.2, C73.1, C75.1, C76.1, C79.1, C100.2, C102.1, C103.1, C104.2, C105.1, D11.1 (K), D13.2 (A), D17.2 (A), D19.1 (K), E1.32, E1.33, E1.40, EAR1.1, IC1.40 (GND), IC2.29 (GND), IC5.14 (Vss), IC6.16 (VSS), IC7.16 (VSS), IC8.16 (VSS), IC9.16 (VSS), IC10.16 (VSS), IC11.16 (VSS), IC12.16 (VSS), IC13.16 (VSS), IC14.5 (GROUND), IC15.1 (NC), IC15.16 (VSS), IC16.1 (NC), IC16.16 (VSS), IC17.1 (NC), IC17.16 (VSS), IC18.1 (NC), IC18.16 (VSS), IC19.1 (NC), IC19.16 (VSS), IC20.1 (NC), IC20.16 (VSS), IC21.1 (NC), IC21.16 (VSS), IC22.1 (NC), IC22.16 (VSS), IC27.20 (VSS), IC28.7 (GND), L1.1, LS1.1, MIC1.1, OKI-L1.2, R37.2, R43.2, R46.2, R47.1, R50.2, R52.2, R53.2, R56.1, R58.2, R63.1, R80.1, R81.1, R82.1, R83.1, R84.1, R85.1, R86.1, REG1.2 (GND), SW1.1 (A), SW2.1, TI-3.1, TR3.3 (E), TR4.3 (E), TV1.4 (GND)
HALTL: E1.14, IC2.18 (HALTL)
INTL: E1.12, IC2.16 (INTL), R26.2
IOREQL: E1.16, IC2.20 (IOREQL), R27.1
IORQULAL: E1.39, IC1.33 (IORFQL), R27.2, TR6.3 (E)
LKU: E1.44, J3.2
LKV: E1.43, J2.2
M1L: E1.23, IC2.27 (M1L)
MREQL: E1.15, IC1.38 (MREQL), IC2.19 (MREQL), IC27.36 (MREQL), IC28.1, JROM1.2
NMIL: E1.13, IC2.17 (NMIL), R28.1
unnamed: C31.1, MIC1.2
unnamed: C31.2, R35.2
unnamed: C32.2, R36.2
unnamed: C38.1, C39.2, R46.1
unnamed: C38.2, R45.2, X2.2
unnamed: C43.1, R60.1, R61.1
unnamed: C72.1, R44.2, X2.1
unnamed: C73.2, X1.1
unnamed: D1.2 (A), KB2.1
unnamed: D2.2 (A), KB2.2
unnamed: D3.2 (A), KB2.3
unnamed: D4.2 (A), KB2.4
unnamed: D5.2 (A), KB2.5
unnamed: D6.2 (A), KB2.6
unnamed: D7.2 (A), KB2.7
unnamed: D8.2 (A), KB2.8
unnamed: D9.1 (K), TR7.2 (B)
unnamed: C46.2, D11.2 (A), D18.1 (K)
unnamed: C32.1, C35.1, D9.2 (A), D13.1 (K), IC1.28 (CASS/SPKR), R35.1, R90.2
unnamed: C80.2, D15.2 (A), D17.1 (K)
unnamed: C79.2, D18.2 (A), R79.2
unnamed: EAR1.2, R36.1, R37.1
unnamed: IC1.1 (CASL), J1.2
unnamed: IC1.18 (D0), IC6.2 (DIN), IC6.14 (DOUT), R1.1
unnamed: IC1.21 (D1), IC7.2 (DIN), IC7.14 (DOUT), R2.1
unnamed: IC1.22 (D2), IC8.2 (DIN), IC8.14 (DOUT), R3.1
unnamed: IC1.25 (D3), IC9.2 (DIN), IC9.14 (DOUT), R4.1
unnamed: IC1.27 (D4), IC10.2 (DIN), IC10.14 (DOUT), R5.1
unnamed: IC1.29 (D5), IC11.2 (DIN), IC11.14 (DOUT), R6.1
unnamed: IC1.30 (D6), IC12.2 (DIN), IC12.14 (DOUT), R7.1
unnamed: IC1.31 (D7), IC13.2 (DIN), IC13.14 (DOUT), R8.1
unnamed: IC1.5 (DMA0), IC6.7 (A1), IC7.7 (A1), IC8.7 (A1), IC9.7 (A1), IC10.7 (A1), IC11.7 (A1), IC12.7 (A1), IC13.7 (A1), R17.1, R80.2
unnamed: IC1.6 (DMA1), IC6.11 (A4), IC7.11 (A4), IC8.11 (A4), IC9.11 (A4), IC10.11 (A4), IC11.11 (A4), IC12.11 (A4), IC13.11 (A4), R18.1, R81.2
unnamed: IC1.7 (DMA2), IC6.5 (A0), IC7.5 (A0), IC8.5 (A0), IC9.5 (A0), IC10.5 (A0), IC11.5 (A0), IC12.5 (A0), IC13.5 (A0), R19.1, R82.2
unnamed: IC1.8 (DMA3), IC6.13 (A6), IC7.13 (A6), IC8.13 (A6), IC9.13 (A6), IC10.13 (A6), IC11.13 (A6), IC12.13 (A6), IC13.13 (A6), R20.1, R83.2
unnamed: IC1.9 (DMA4), IC6.12 (A3), IC7.12 (A3), IC8.12 (A3), IC9.12 (A3), IC10.12 (A3), IC11.12 (A3), IC12.12 (A3), IC13.12 (A3), R21.1, R84.2
unnamed: IC1.10 (DMA5), IC6.10 (A5), IC7.10 (A5), IC8.10 (A5), IC9.10 (A5), IC10.10 (A5), IC11.10 (A5), IC12.10 (A5), IC13.10 (A5), R22.1, R85.2
unnamed: IC1.11 (DMA6), IC6.6 (A2), IC7.6 (A2), IC8.6 (A2), IC9.6 (A2), IC10.6 (A2), IC11.6 (A2), IC12.6 (A2), IC13.6 (A2), R23.1, R86.2
unnamed: IC1.4 (DRAMWEL), IC6.3 (WRL), IC7.3 (WRL), IC8.3 (WRL), IC9.3 (WRL), IC10.3 (WRL), IC11.3 (WRL), IC12.3 (WRL), IC13.3 (WRL)
unnamed: IC1.12 (INTL), R26.1
unnamed: IC1.19 (KB0), KB1.1, R69.2
unnamed: IC1.20 (KB1), KB1.2, R68.2
unnamed: IC1.23 (KB2), KB1.3, R67.2
unnamed: IC1.24 (KB3), KB1.4, R66.2
unnamed: IC1.26 (KB4), KB1.5, R65.2
unnamed: IC1.39 (OSC), X1.2
unnamed: IC1.35 (RASL), IC6.4 (~RAS), IC7.4 (~RAS), IC8.4 (~RAS), IC9.4 (~RAS), IC10.4 (~RAS), IC11.4 (~RAS), IC12.4 (~RAS), IC13.4 (~RAS), J1.6
unnamed: IC1.34 (ROMCSL), R33.2
unnamed: C30.2, IC1.13 (VCC/VAN), LK4.1, R34.2
unnamed: IC2.6 (~CLK), LK1.1, R25.1, TR3.1 (C)
unnamed: IC5.20 (CS), JROM1.1
unnamed: IC5.27 (OE1L), JROM1.4
unnamed: IC6.15 (CASL), IC7.15 (CASL), IC8.15 (CASL), IC9.15 (CASL), IC10.15 (CASL), IC11.15 (CASL), IC12.15 (CASL), IC13.15 (CASL), J1.1
unnamed: C52.2, IC14.4 (B-Y_INPUT), LK3.1, R76.1
unnamed: C76.2, IC14.3 (CHROMA_BIAS), LK4.2, R78.1
unnamed: C37.1, IC14.18 (CHROMA_LAG), R45.1
unnamed: C39.1, IC14.1 (CHROMA_LEAD)
unnamed: IC14.17 (CHROMA_OSC_OUTPUT), R43.1, R44.1
unnamed: C65.1, IC14.13 (CHROMA_SUB-CARRIER), R72.2
unnamed: C53.2, IC14.2 (R-Y_INPUT), LK2.1, R77.1
unnamed: IC14.12 (VIDEO_INPUT), R42.2
unnamed: IC15.5 (A0), IC16.5 (A0), IC17.5 (A0), IC18.5 (A0), IC19.5 (A0), IC20.5 (A0), IC21.5 (A0), IC22.5 (A0), IC27.33 (MA0)
unnamed: IC15.7 (A1), IC16.7 (A1), IC17.7 (A1), IC18.7 (A1), IC19.7 (A1), IC20.7 (A1), IC21.7 (A1), IC22.7 (A1), IC27.31 (MA2)
unnamed: IC15.6 (A2), IC16.6 (A2), IC17.6 (A2), IC18.6 (A2), IC19.6 (A2), IC20.6 (A2), IC21.6 (A2), IC22.6 (A2), IC27.32 (MA1)
unnamed: IC15.12 (A3), IC16.12 (A3), IC17.12 (A3), IC18.12 (A3), IC19.12 (A3), IC20.12 (A3), IC21.12 (A3), IC22.12 (A3), IC27.30 (MA3)
unnamed: IC15.11 (A4), IC16.11 (A4), IC17.11 (A4), IC18.11 (A4), IC19.11 (A4), IC20.11 (A4), IC21.11 (A4), IC22.11 (A4), IC27.29 (MA4)
unnamed: IC15.10 (A5), IC16.10 (A5), IC17.10 (A5), IC18.10 (A5), IC19.10 (A5), IC20.10 (A5), IC21.10 (A5), IC22.10 (A5), IC27.28 (MA5)
unnamed: IC15.13 (A6), IC16.13 (A6), IC17.13 (A6), IC18.13 (A6), IC19.13 (A6), IC20.13 (A6), IC21.13 (A6), IC22.13 (A6), IC27.27 (MA6)
unnamed: IC15.9 (A7), IC16.9 (A7), IC17.9 (A7), IC18.9 (A7), IC19.9 (A7), IC20.9 (A7), IC21.9 (A7), IC22.9 (A7), IC27.26 (MA7)
unnamed: C105.2, IC15.15 (CASL), IC16.15 (CASL), IC17.15 (CASL), IC18.15 (CASL), IC19.15 (CASL), IC20.15 (CASL), IC21.15 (CASL), IC22.15 (CASL), IC27.34 (CASL)
unnamed: IC15.4 (RASL), IC16.4 (RASL), IC17.4 (RASL), IC18.4 (RASL), IC19.4 (RASL), IC20.4 (RASL), IC21.4 (RASL), IC22.4 (RASL), IC28.4, R88.1
unnamed: IC15.3 (WRL), IC16.3 (WRL), IC17.3 (WRL), IC18.3 (WRL), IC19.3 (WRL), IC20.3 (WRL), IC21.3 (WRL), IC22.3 (WRL), IC27.39 (WRL), IC28.8
unnamed: IC27.4 (DMA0), R17.2
unnamed: IC27.7 (DMA1), R18.2
unnamed: IC27.10 (DMA2), R19.2
unnamed: IC27.13 (DMA3), R20.2
unnamed: IC27.16 (DMA4), R21.2
unnamed: IC27.19 (DMA5), R22.2
unnamed: IC27.23 (DMA6), R23.2
unnamed: C102.2, IC27.1 (DRASLL), R87.2
unnamed: C103.2, IC27.35 (MREQDL), R88.2, R89.2
unnamed: IC27.24 (TS1), OKI-H1.1, OKI-L1.1, TI1.1
unnamed: IC27.25 (TS2), OKI1.2, TI-3.2, TI-4.2
unnamed: IC28.2, IC28.3
unnamed: IC28.6, IC28.9
unnamed: IC28.10, IC28.13
unnamed: IC28.12, J1.3
unnamed: IC28.11, J1.4
unnamed: J1.5, R87.1
unnamed: C100.1, SW1.2 (B), TV1.3 (Chan)
unnamed: R61.2, T1.1 (AA)
unnamed: T1.2 (AB), TR4.2 (B)
unnamed: R48.2, R49.2, R50.1, TR1.2 (B)
unnamed: C65.2, R51.2, TR1.1 (C), TR2.2 (B)
unnamed: R52.1, TR1.3 (E)
unnamed: C25.1, C40.1, C42.1, R49.1, R51.1, R64.1, R72.1, TR2.1 (C), TV1.1 (+5V)
unnamed: C67.1, R24.1, TR3.2 (B)
unnamed: C74.2, R58.1, R59.1, TR5.2 (B)
unnamed: R60.2, TR5.1 (C)
unnamed: LS1.2, TR7.3 (E)
unnamed: C70.1, R75.1, TR8.2 (B)
unnamed: C71.1, R77.2, TR8.1 (C)
unnamed: C68.1, R74.1, TR9.2 (B)
unnamed: C69.1, R76.2, TR9.1 (C)
PHICPU: C67.2, E1.34, IC1.32 (PHICPU), LK1.2, R24.2, R73.1
RDL: E1.17, IC1.3 (RDL), IC2.21 (RDL), IC5.22 (OE0L), IC27.38 (RDL)
RESETL: C27.1, E1.46, IC2.26 (RESETL), R31.2, SW2.2
RFSH: E1.24
RFSHL: IC2.28 (RFSHL)
ROMCSL: E1.51, JROM1.3, R33.1
U: C69.2, IC1.15 (U), J3.1, LK3.2, R56.2
V: C71.2, IC1.16 (V), J2.1, LK2.2, R63.2
VIDEO: E1.41, R53.1, TR2.3 (E), TV1.2 (1P)
WAITL: E1.20, IC2.24 (WAITL), R29.1
WRL: E1.18, IC1.2 (WRL), IC2.22 (WRL), IC28.5
Y: C68.2, C70.2, E1.42, IC1.17 (YL), R47.2, R48.1

Notes on the sheet:
X1 14Mhz X2 4.433619Mhz +/- 10PPM ABSOLUTE ALL DIODES UNLESS STATED ARE 1N4148
DRAM SUPPLY
ANALOGUE SUPPLY
Underside Comp Side A B A14 1 A15 A13 2 A13 +5V 3 D7 +9V 4 NC SLOT 5 SLOT 0V 6 D0 0V 7 D1 -CK 8 D2 A0 9 D6 A1 10 D5 A2 11 D3 A3 12 D4 -IO_RQULA 13 -INT 0V 14 -NMI VIDEO 15 -HALT -Y 16 -M_REQ V 17 -IO_REQ U 18 -RD -BUS_REQ 19 -WR -RESET 20 -5V A7 21 -WAIT A6 22 +12V A5 23 -12V (12VAC) A4 24 -M1 -ROM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
1-2 & 3-4 = NEC 1-3 & 2-4 = Hitachi

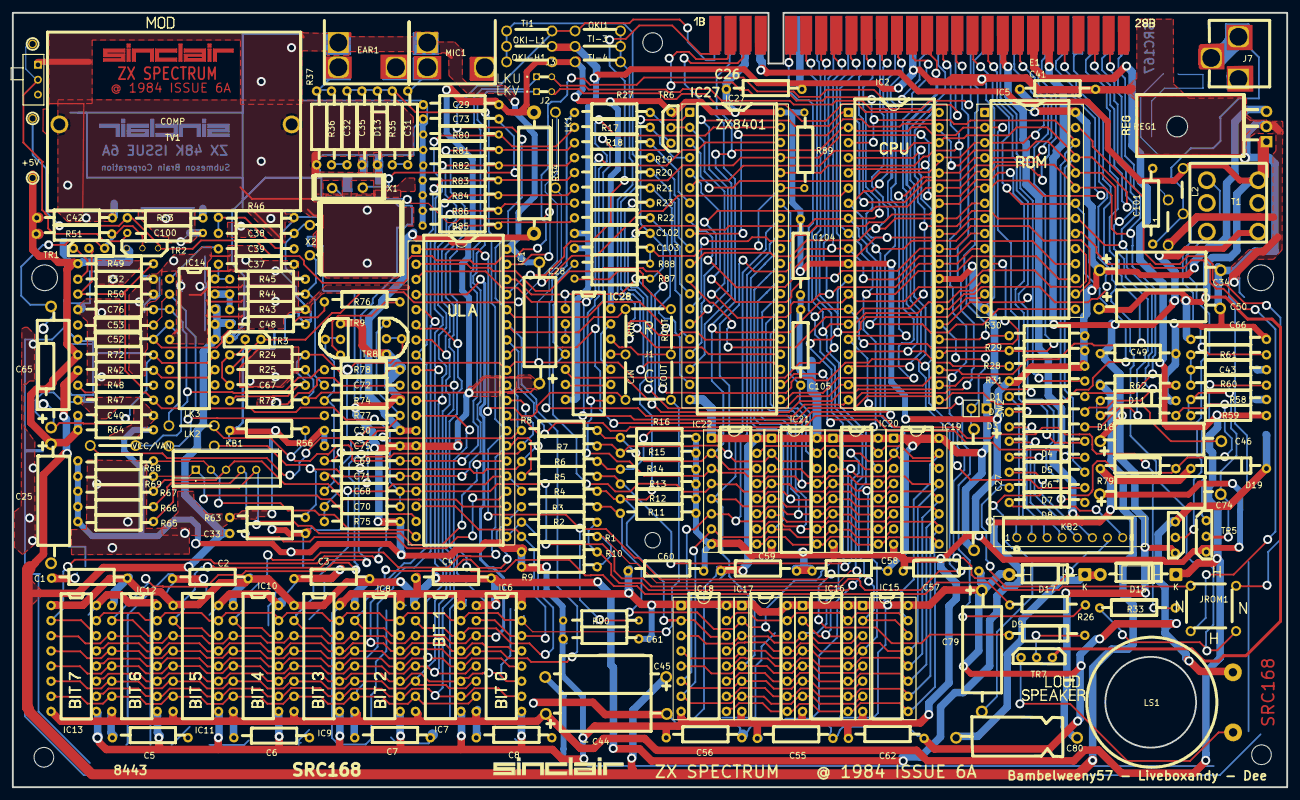
[picture p10: board Issue6A.kicad_pcb from above]

Board: 2 copper layers, 214.0 x 130.0 mm, 218 parts (0 on the bottom side), 158 nets.
