liveboxandy/ZX-Spectrum-48K-Issue-6A/(commit log)

2026-10-21 Initial Release of 6A Kicad Project
    Initial Release of 6A Kicad Project.
2026-10-21 Update README with project and component information
    Revised project details and component notes for ZX Spectrum Issue 6A PCB.
2026-10-21 Add Gerbers & Updated ibom
    Added Gerbers (I still would be wary about getting a PCB made). Updated PCB to change polygons to zones so that the ibom includes them.
