liveboxandy/ZX-Spectrum-48K-Issue-6A/(notices)

Notices in the files:
STPS/SS12SDH4.stp:
author */ ('License CC BY-ND 4.0'),
